sean920310/rubik-s-cube-solver-robot/README.md

# rubik-s-cube-solver-robot
https://github.com/sean920310/rubik-s-cube-solver-robot/blob/main/%E5%B0%88%E9%A1%8C%E5%A0%B1%E5%91%8A.pdf
