sean920310/rubik-s-cube-solver-robot/dictionary.py

D = {

"F"       : "a",  
"F2"      : "b",  
"F'"      : "c",  
"(F B)"   : "d", 
"(F2 B)"  : "e",  
"(F' B)"  : "f", 
"B"       : "g", 
"(F B2)"  : "h", 
"(F2 B2)" : "i", 
"(F' B2)" : "j", 
"B2"      : "k", 
"(F B')"  : "l",  
"(F2 B')" : "m",  
"(F' B')" : "n",  
"B'"      : "o", 

"L"       : "p",  
"L2"      : "q",  
"L'"      : "r",  
"(R L)"   : "s",  
"(R L2)"  : "t",  
"(R L')"  : "u",  
"R"       : "v", 
"(R2 L)"  : "w", 
"(R2 L2)" : "x", 
"(R2 L')" : "y", 
"R2"      : "z",  
"(R' L)"  : "A",  
"(R' L2)" : "B",  
"(R' L')" : "C", 
"R'"      : "D", 

"U"       : "E", 
"U2"      : "F", 
"U'"      : "G",  
"(U D)"   : "H",  
"(U2 D)"  : "I", 
"(U' D)"  : "J",  
"D"       : "K", 
"(U D2)"  : "L",  
"(U2 D2)" : "M", 
"(U' D2)" : "N", 
"D2"      : "O", 
"(U D')"  : "P",
"(U2 D')" : "Q",
"(U' D')" : "R", 
"D'"      : "S", 
    
}


print(D["D'"])
